ut-ims-robotics/p2rnalaas-thesis-2023-robotont-mechanics-addon-swerve-drive/images/swerve_drive_module_assembled_PCblend_on_chassis.jpg

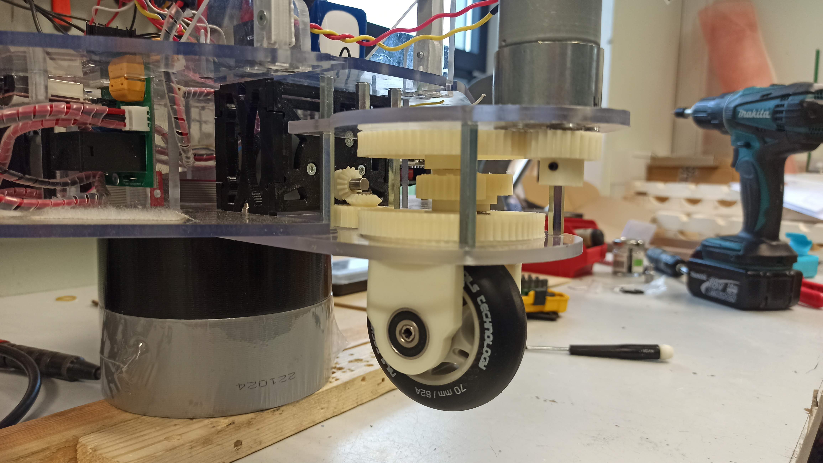
images/swerve_drive_module_assembled_PCblend_on_chassis.jpg
