ut-ims-robotics/p2rnalaas-thesis-2023-robotont-mechanics-addon-swerve-drive/README.md

# p2rnalaas-thesis-2023-robotont-mechanics-addon-swerve-drive
Additional pictures, videos and programs for the mechanical Robotont add-on for swerve drive.
