ut-ims-robotics/p2rnalaas-thesis-2023-robotont-mechanics-addon-swerve-drive/images/3Dprinted_gears.jpg

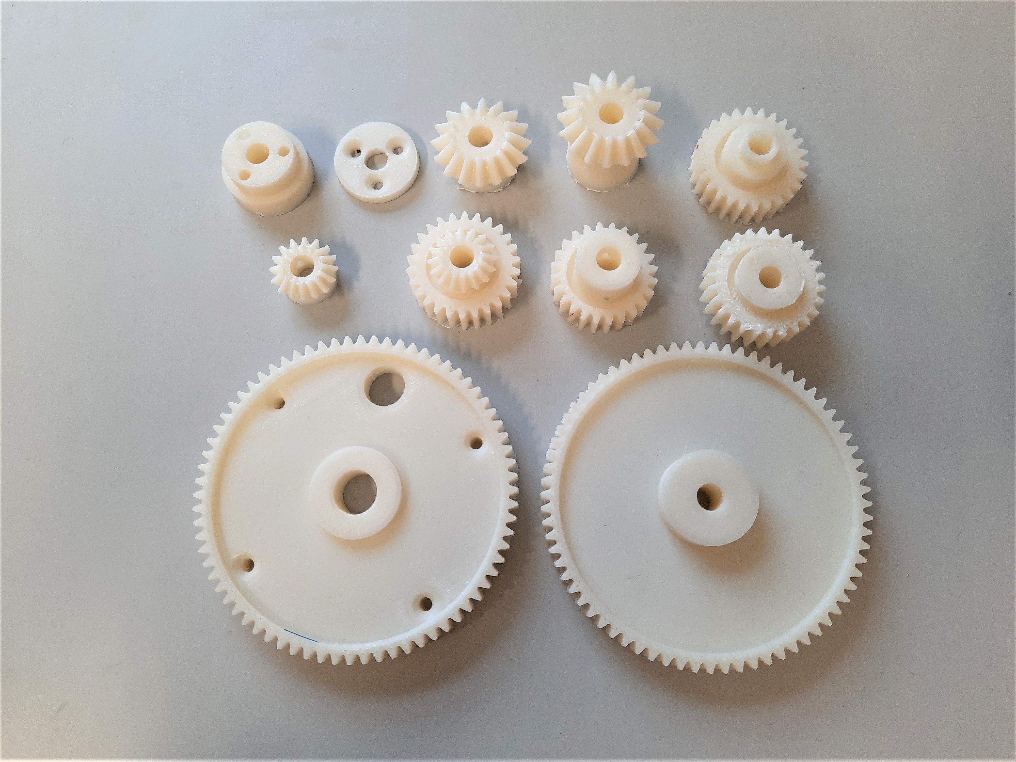
images/3Dprinted_gears.jpg
