ut-ims-robotics/p2rnalaas-thesis-2023-robotont-mechanics-addon-swerve-drive/images/Screenshot_20230506_165944_WiFi Controller.jpg

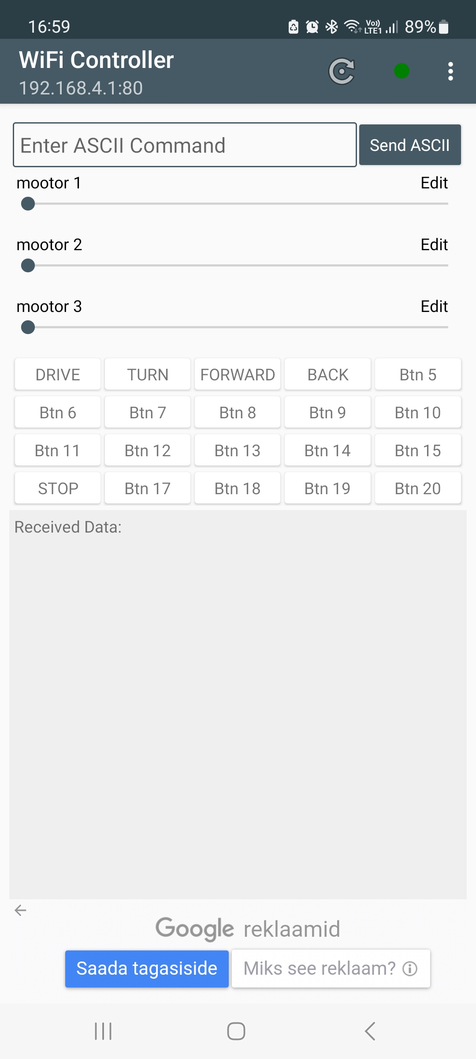
images/Screenshot_20230506_165944_WiFi Controller.jpg
