ut-ims-robotics/p2rnalaas-thesis-2023-robotont-mechanics-addon-swerve-drive/Lisa 1 - BOM.pdf

## Lisa 1 – Materjalide nimekiri ühe mooduli kohta

Nr | Komponendi kirjeldus | Failinimi | Kogus | Tellimisviit | Kas prinditav/ tellitav/ freesitav
1 | Pololu 19:1 mootor 37Dx68L mm 12V koos 64 CPR kodeerijaga | BDSG-37-40-R150_motor [38] | 2 | https://www.pololu.com/product/4751/spe cs (https://www.pololu.com/product/4751/specs) | tellitav
2 | Rulluisuratas

70x25mm

scooter_wheel_7

0mm

1 | https://www.pololu.c

om/product/3272 (https://www.pololu.com/product/3272)

kasutatud

prototüübis:

https://kaup24.ee/et/s

port-puhkus-

turism/jalgrattad-

rulluisud-

rulad/rulluisud/rullui

surattad-nils-

extreme-70x24-mm-

82a-

mustad?id=5890108

&mid=7538983&ut

m_campaign=17169

_EE&utm_content=c

art_block&utm_med

ium=email&utm_so

urce=transactional&

utm_subscriber=119

580977 (https://kaup24.ee/et/sport-puhkus-turism/jalgrattad-rulluisud-rulad/rulluisud/rulluisurattad-nils-extreme-70x24-mm-82a-mustad?id=5890108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)

tellitav

3 | Ratta kinnitus võllile (võlli diameeter 6mm) | wheel_mount_h ub2 | 1 | https://www.pololu.com/product/2674 (https://www.pololu.com/product/2674) (komplekt) | tellitav/ prinditav
4 | Ratta kinnituse vastus | wheel_mount_h ub1 | 1 | | tellitav/ prinditav
5 | ratta võll l=59.1mm tihke istuga | shaft_round_wc ut_6mm_for_wh eel | 1 | https://www.alas-kuul.ee/lineaarjuhik-karastatud-ja-lihvitud-59-hrc-iso-h6-ots-markeeritud-rohelise-varviga-ljm-6-mad-1000-mm (https://www.alas-kuul.ee/lineaarjuhik-karastatud-ja-lihvitud-59-hrc-iso-h6-ots-markeeritud-rohelise-varviga-ljm-6-mad-1000-mm) | tellitav
6 | vedava mootori ülekande võll l=16.7mm tihke istuga | shaft_round_wc ut_6mm_for_mo tor_transmission 1 | 1 | https://www.alas-kuul.ee/lineaarjuhik-karastatud-ja-lihvitud-59-hrc-iso-h6-ots-markeeritud-rohelise-varviga-ljm-6-mad-1000-mm (https://www.alas-kuul.ee/lineaarjuhik-karastatud-ja-lihvitud-59-hrc-iso-h6-ots-markeeritud-rohelise-varviga-ljm-6-mad-1000-mm) | tellitav
7 | keskmiste hammasrataste ülekande võll l=45.1mm | shaft_round_wc ut_6mm_for_mi dgears | 1 | https://www.alas-kuul.ee/lineaarjuhik-karastatud-ja-lihvitud-59-hrc-iso-h6-ots-markeeritud-rohelise-varviga-ljm-6-mad-1000-mm (https://www.alas-kuul.ee/lineaarjuhik-karastatud-ja-lihvitud-59-hrc-iso-h6-ots-markeeritud-rohelise-varviga-ljm-6-mad-1000-mm) | tellitav
8 | võll ratta kõrvale koonushammasrat aste ülekandele l=49.5mm tihke istuga | shaft_round_wc ut_6mm_for_be vel_wheel_trans mission | 1 | https://www.alas-kuul.ee/lineaarjuhik-karastatud-ja-lihvitud-59-hrc-iso-h6-ots-markeeritud- (https://www.alas-kuul.ee/lineaarjuhik-karastatud-ja-lihvitud-59-hrc-iso-h6-ots-markeeritud-rohelise-varviga-ljm-6-mad-1000-mm) | tellitav

| | | | rohelise-varviga-ljm-6-mad-1000-mm (https://www.alas-kuul.ee/lineaarjuhik-karastatud-ja-lihvitud-59-hrc-iso-h6-ots-markeeritud-rohelise-varviga-ljm-6-mad-1000-mm)
9 | Koonushammasra tas ratta ülekandele väline 1.5M 16GT | bevel_gear_1.5 M_16GT_35570 700 | 1 | https://www.maedler.de/Article/35570700 (https://www.maedler.de/Article/35570700) | tellitav/ prinditav
10 | Koonushammasra tas ratta ülekandele sisemine 1.5M 16GT | bevel_gear_1.5 M_16GT_35570 700_inner | 1 | https://www.maedler.de/Article/35570700 (https://www.maedler.de/Article/35570700) | tellitav/ prinditav
11 | Silinderhammasra tas 72T 1M alumine | spur_gear_lower _1M_72T_2830 7201 | 1 | https://www.maedler.de/Article/28307201 (https://www.maedler.de/Article/28307201) | tellitav/ prinditav
12 | Silinderhammasra tas 72 1M ülemine | spur_gear_upper _1M_72T_2830 7201 | 1 | https://www.maedler.de/Article/28307201 (https://www.maedler.de/Article/28307201) | tellitav/ prinditav
13 | 72T-de vaheline hammasratas 26T 1M | spur_gear_long_ hub_26T_28302 601 | 1 | https://www.maedler.de/Article/28302601 (https://www.maedler.de/Article/28302601) | tellitav/ prinditav
14 | 72T-de vaheline hammasratas 26 T 1M, topelt keskmikuga, koonushammasrat ta võllil | spur_gear_26T_ mid_double_hub _28302601 | 1 | https://www.maedler.de/Article/28302601 (https://www.maedler.de/Article/28302601) | tellitav/ prinditav
15 | Koonushammasra tas 1M 16GT pöörava mootori (1.) nurkülekanne | small_bevel_gea r_1M_16GT_35 550701 | 1 | https://www.maedler.de/Article/35550701 (https://www.maedler.de/Article/35550701) | tellitav/ prinditav

16 | Koonushammasra tas 1M 16GT pöörava mootori nurkülekanne, lühem | small_bevel_gea r_CUT_1M_16 GT_35550701 | 1 | https://www.maedler.de/Article/35550701 (https://www.maedler.de/Article/35550701) | tellitav/ prinditav
17 | 26T 1M hammasratta väline ülekanne 1. mootori (pöörav) jaoks | spur_gear_CUT _26T_28302601 | 1 | https://www.maedler.de/Article/28302601 (https://www.maedler.de/Article/28302601) | tellitav/ prinditav
18 | Komponendi 16 ja 17 ühendatud versioon (alternatiivne printimiseks) | small_bevel_gea r1M_merged_wi th_spur_gear26 T_28302601_35 550701 | 1 | - | prinditav
19 | Silinderhammasra tas 24T 1M vedava mootori ülekanne | spur_gear_secon d_motor_transm ission_1M_24T _28302401 | 1 | https://www.maedler.de/Article/28302401 (https://www.maedler.de/Article/28302401) | tellitav/ prinditav
20 | Rulluisurattale 70mm kuullaager sisemine D=6mm, väline D=19mm, W=6mm | ball_bearing_SK F626 | 2 | https://tellimiskeskus.moduator.ee/index.php?pg=1&tg=155&kg=30&aid=52789 (https://tellimiskeskus.moduator.ee/index.php?pg=1&tg=155&kg=30&aid=52789) | tellitav
21 | Nõellaager sisemine D=6mm, väline 10mm, W=8mm | needle_roller_be aring 6-10-8 | 3 | https://tellimiskeskus.moduator.ee/index.php?pg=1&tg=155&kg=40&aid=67110 (https://tellimiskeskus.moduator.ee/index.php?pg=1&tg=155&kg=40&aid=67110) | tellitav
22 | Üherealine laager sisemine D=6mm, | ball_bearing_68 _iso_6-10-3 | 1 | https://tellimiskeskus.moduator.ee/index.p (https://tellimiskeskus.moduator.ee/index.php?pg=1&tg=155&kg=30&aid=79536) | tellitav

| väline D=10mm, W=3mm | | | hp?pg=1&tg=155&k g=30&aid=79536 (https://tellimiskeskus.moduator.ee/index.php?pg=1&tg=155&kg=30&aid=79536)
23 | Rattahoidja detaili plaat | body_wheel_hol der_plate | 1 | - | prinditav
24 | Rattahoidja detaili kõrv väiksem | body_wheel_hol der_ear_smaller | 1 | - | prinditav
25 | Rattahoidja detaili kõrv suurem | body_wheel_hol der_ear_bigger | 1 | - | prinditav
26 | Kere alumine plaat | bottom_base_pl ate | 1 | - | freesitav
27 | Kere ülemine plaat | upper_base_plat e | 1 | - | freesitav
28 | Vahepuks ema-ema kuuskant M3 sise kinnitus pikkus 40mm | support1_betwe en_plates [38] | 4 | https://www.tme.eu/ee/details/tff-m3x40_dr113/metallpuksid/dremec/113x40/ (https://www.tme.eu/ee/details/tff-m3x40_dr113/metallpuksid/dremec/113x40/) | tellitav
29 | Vahepuks ema-ema kuuskant M3 sise kinnitus pikkus 18mm | support2_upper_ plate [38] | 3 | https://www.tme.eu/ee/details/tff-m3x18_dr113/metallpuksid/dremec/113x18/ (https://www.tme.eu/ee/details/tff-m3x18_dr113/metallpuksid/dremec/113x18/) | tellitav
30 | M3 koonuspeaga kruvi 10mm | Bolt_m3_10mm [38] | 20 | https://ee.farnell.com/tr-fastenings/m3-10-m4a2mccsk-t10sf/screw-countersunk-hex-socket-m3/dp/2846508 (https://ee.farnell.com/tr-fastenings/m3-10-m4a2mccsk-t10sf/screw-countersunk-hex-socket-m3/dp/2846508) | tellitav
31 | M3 koonuspeaga kruvi 12mm | Bolt_m3_12mm 25] | 2 | https://ee.farnell.com/tr-fastenings/m3-12- (https://ee.farnell.com/tr-fastenings/m3-12-m4a2mc-s50-csk-t10/screw-countersunk-hex-socket-m3/dp/2846515) | tellitav

| | | | m4a2mc-s50-csk-t10/screw-countersunk-hex-socket-m3/dp/2846515 (https://ee.farnell.com/tr-fastenings/m3-12-m4a2mc-s50-csk-t10/screw-countersunk-hex-socket-m3/dp/2846515)
32 | M3 koonuspeaga kruvi 16mm | Bolt_m3_16mm 25] | 4 | https://uk.farnell.com/multicomp-pro/mp006522/screw -flat-csk-head-pozidriv-m3/dp/3666715?st= m3%20countersink %2016 (https://uk.farnell.com/multicomp-pro/mp006522/screw-flat-csk-head-pozidriv-m3/dp/3666715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) | tellitav
33 | M3 mutter kaheksakant | M3_stopper_nut 25] | 9 | https://ee.farnell.com/tr-fastenings/m3-n5st-z100/nut-locking-steel-bzp-m3-pk100/dp/1420431?st=m3%20stopper%2 0nut (https://ee.farnell.com/tr-fastenings/m3-n5st-z100/nut-locking-steel-bzp-m3-pk100/dp/1420431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) | tellitav
34 | M3 koonuspeaga kruvi 25mm | Bolt_m3_25mm 25] | 3 | https://ee.farnell.com/tr-fastenings/m325krstmcz100/pozi-csk-head-machine-screw-steel/dp/2770707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 %2025 (https://ee.farnell.com/tr-fastenings/m325krstmcz100/pozi-csk-head-machine-screw-steel/dp/2770707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) | tellitav

35 | isekeermestavad kruvid ratta kinnitamiseks M3 6mm | M3x6.0_set_scr ew[39] | 9 | https://ee.farnell.com/tr-fastenings/m3-6-hs45pc-s100/set-screw-socket-pcp-m3x6-pk100/dp/1419732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 q%206 (https://ee.farnell.com/tr-fastenings/m3-6-hs45pc-s100/set-screw-socket-pcp-m3x6-pk100/dp/1419732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) | tellitav
36 | Sisendid (ing. k inserts) M3 6mm | M3_insert_Stan dard [40] | 4 | https://www.prusa3d.com/product/threade d-inserts-m3-standard-100-pcs/ (https://www.prusa3d.com/product/threaded-inserts-m3-standard-100-pcs/) | tellitav
37 | isekeermestavad kruvid kahe puksi vahele 10mm M3 | M3x10.0_set_sc rew[39] | 2 | https://ee.farnell.com/tr-fastenings/m2-10-hs45pc-s25/set-screw-socket-pcp-m2x10-pk25/dp/1419725 (https://ee.farnell.com/tr-fastenings/m2-10-hs45pc-s25/set-screw-socket-pcp-m2x10-pk25/dp/1419725) | tellitav

Kõik hammasrattad on tellitavad, kuid siseaugu diameeter ning keskmiku mõõdud on disainis

modifitseeritud.
