ut-ims-robotics/p2rnalaas-thesis-2023-robotont-mechanics-addon-swerve-drive/images/swerve_drive_model_module_assembly_exploded.PNG

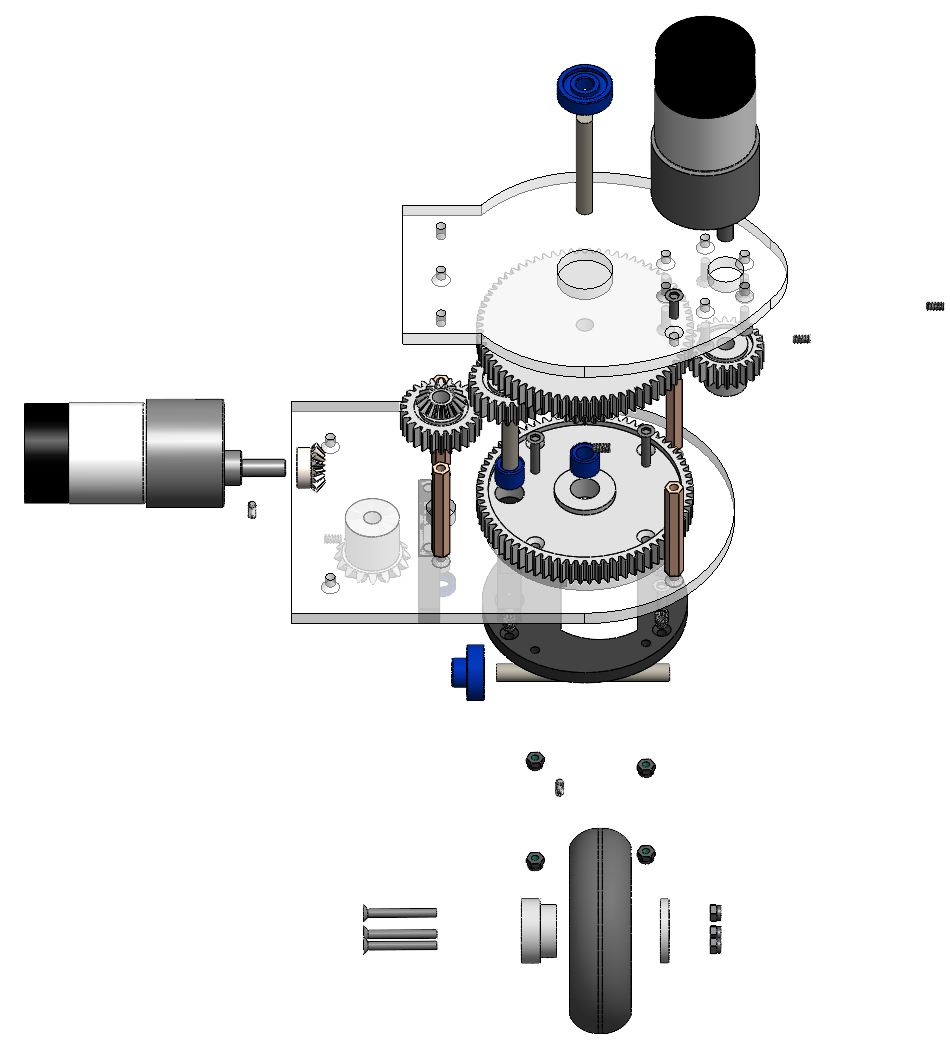
images/swerve_drive_model_module_assembly_exploded.PNG
