ut-ims-robotics/p2rnalaas-thesis-2023-robotont-mechanics-addon-swerve-drive/images/Robtont_chassis_swerve_drive_testing1.jpg

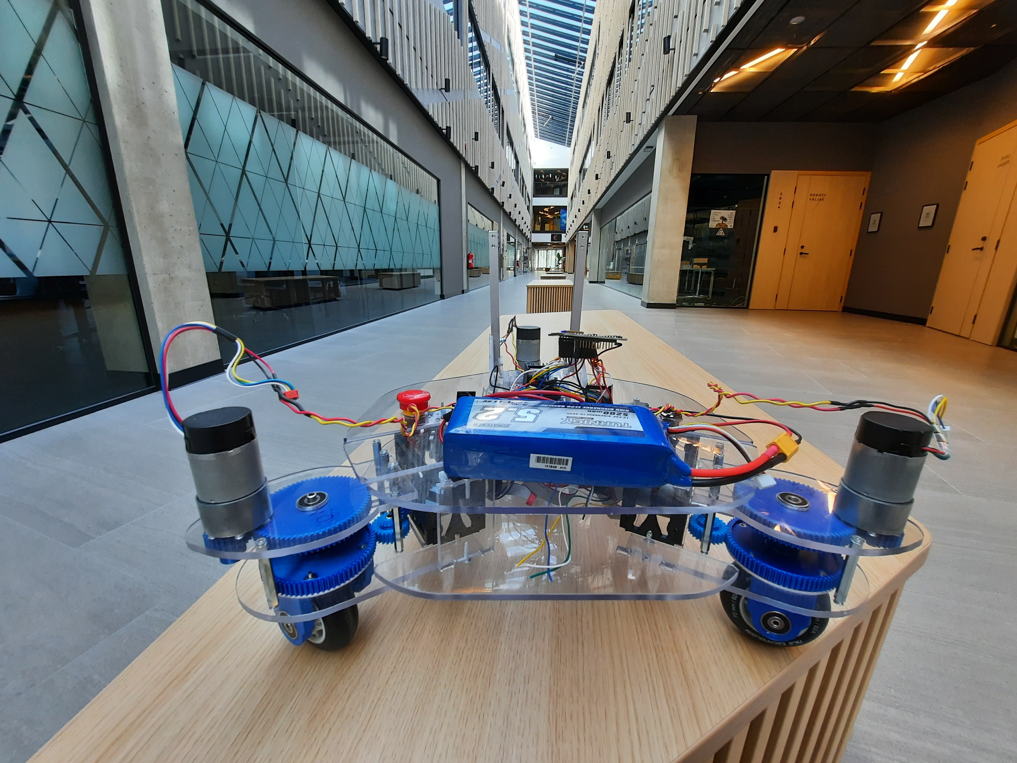
images/Robtont_chassis_swerve_drive_testing1.jpg
