ut-ims-robotics/p2rnalaas-thesis-2023-robotont-mechanics-addon-swerve-drive/images/swerve_drive_electronics_schema_for_testing.png

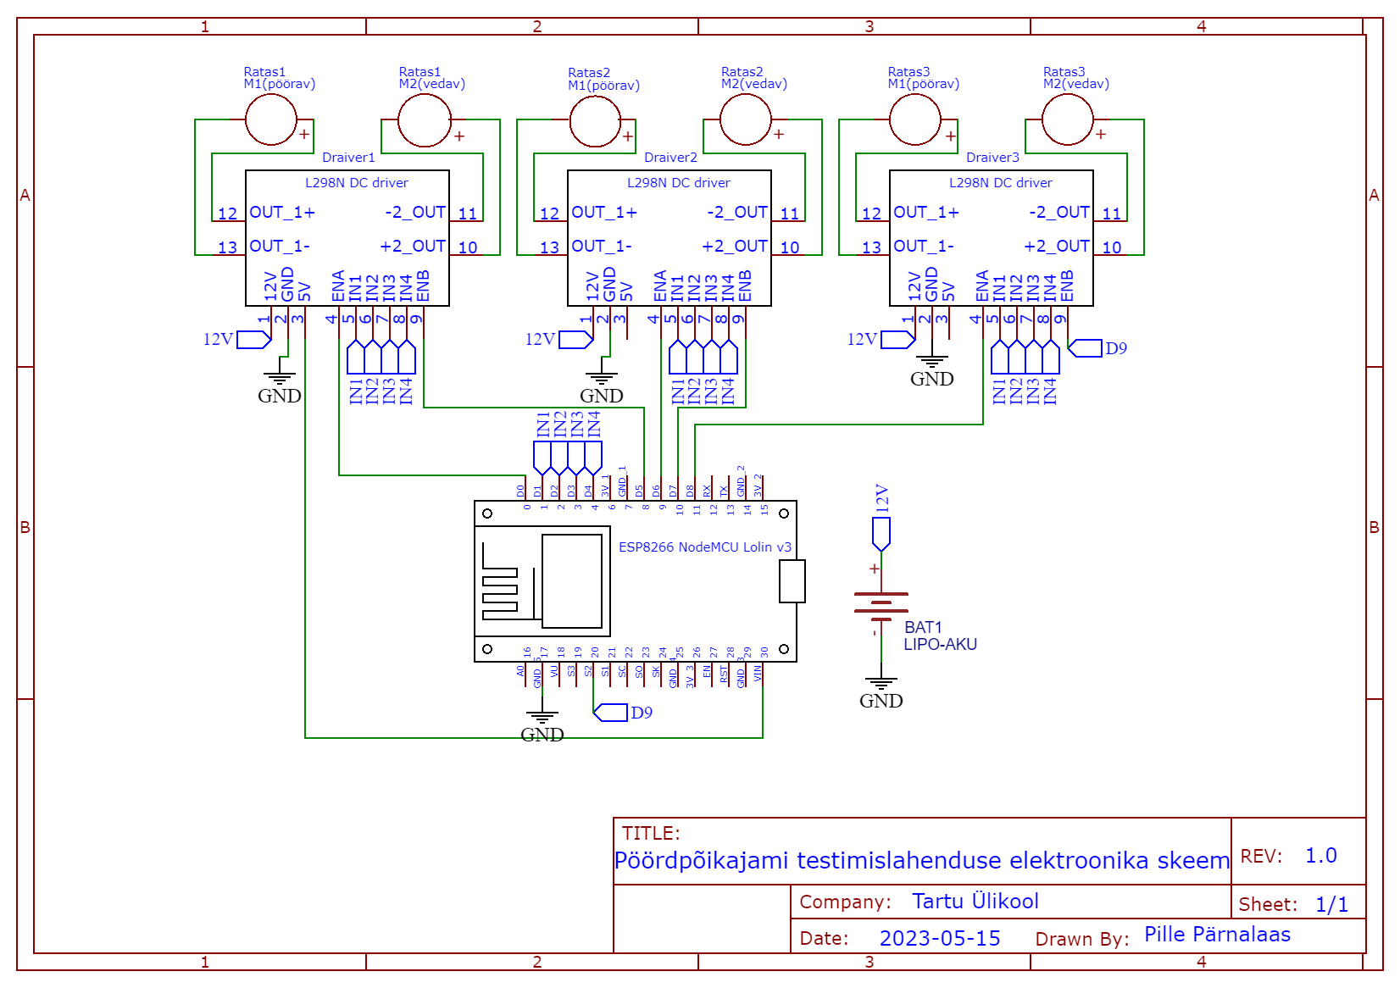
images/swerve_drive_electronics_schema_for_testing.png
